Datnewlevel/Iot_construction_fleet_monitor/Webserver/how_to_install_thingsboard.txt

https://thingsboard.io/docs/user-guide/install/rpi/
